freaklabs/NetRad/Hardware/NetRad-v2.0.pdf

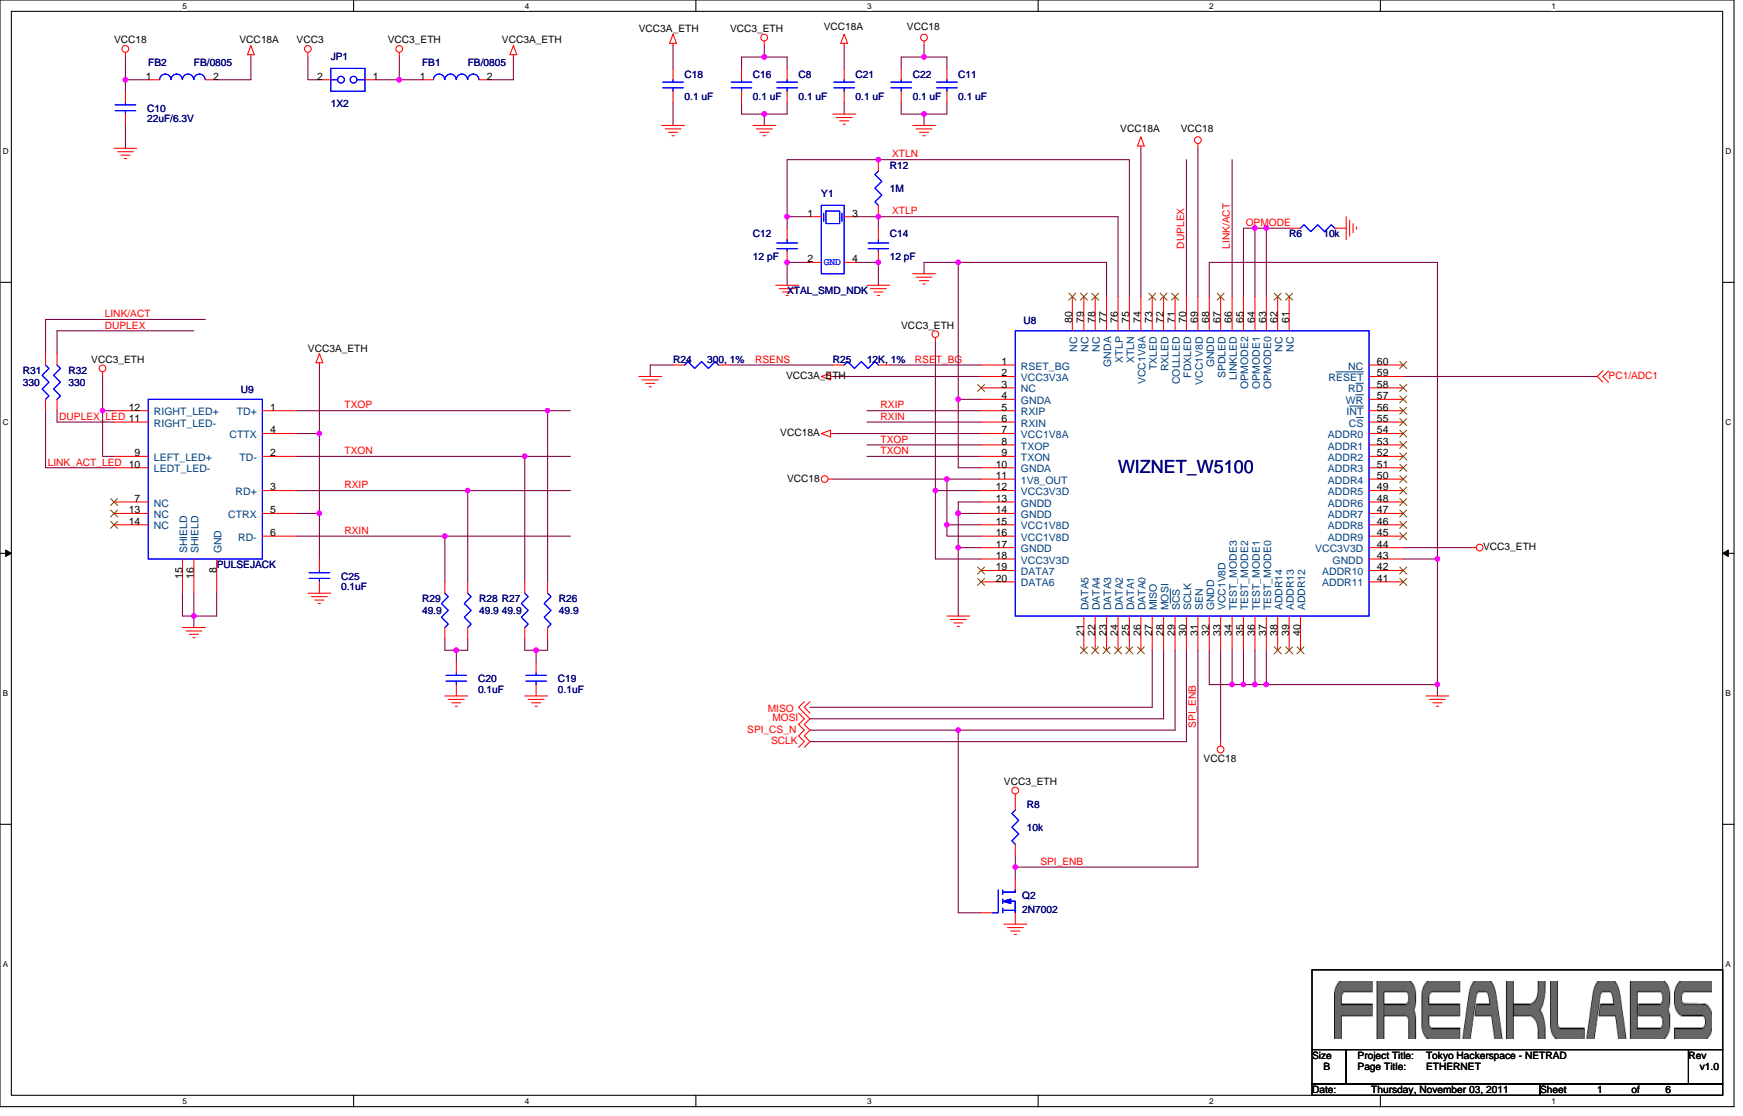
[picture p1: page 1]

NC 61 NC 62 OPMODE0 63 OPMODE1 64 OPMODE2 65 LINKLED 66 SPDLED 67 GNDD 68 VCC1V8D 69 FDXLED 70 COLLLED 71 RXLED 72 TXLED 73 VCC1V8A 74 XTLN 75 XTLP 76 GNDA 77 NC 78 NC 79 NC 80

ADDR12 40 ADDR11 41 ADDR10 42 GNDD 43 VCC3V3D 44 ADDR9 45 ADDR8 46 ADDR7 47 ADDR6 48 ADDR5 49 ADDR4 50 ADDR3 51 ADDR2 52 ADDR1 53 ADDR0 54 CS 55 INT 56 WR 57 RD 58 RESET 59 NC 60

Size Size Size B B B | Project Title: Project Title: Project Title: Tokyo Hackerspace - NETRAD Tokyo Hackerspace - NETRAD Tokyo Hackerspace - NETRAD Page Title: Page Title: Page Title: ETHERNET ETHERNET ETHERNET | Rev Rev Rev v1.0 v1.0 v1.0

Date: Date: Date: Thursday, November 03, 2011 Thursday, November 03, 2011 Thursday, November 03, 2011 | Sheet Sheet Sheet 1 1 1 of of of 6 6 6

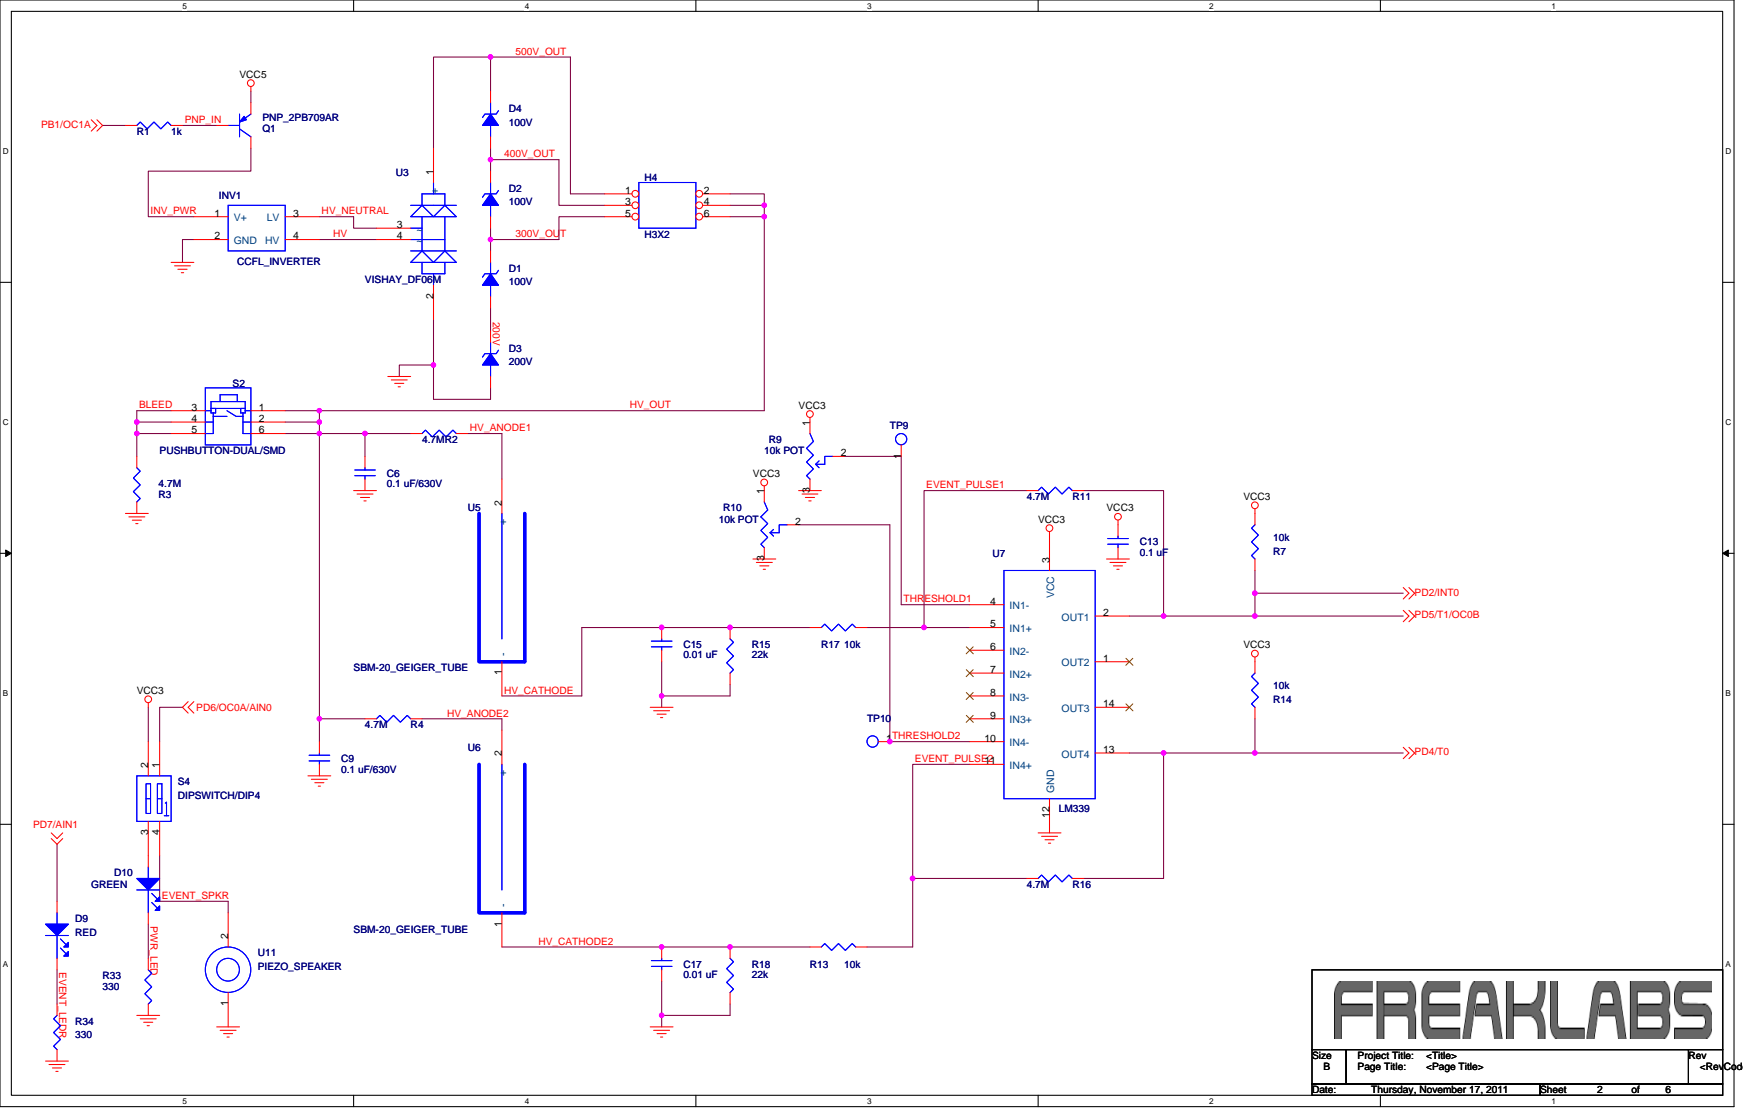
[picture p2: page 2]

Size Size Size B B B | Project Title: Project Title: Project Title: <Title> <Title> <Title> <Page Title> <Page Title> <Page Title> | Rev Rev Rev

Date: Date: Date: Thursday, November 17, 2011 Thursday, November 17, 2011 Thursday, November 17, 2011 | Sheet Sheet Sheet 2 2 2 of of of 6 6 6

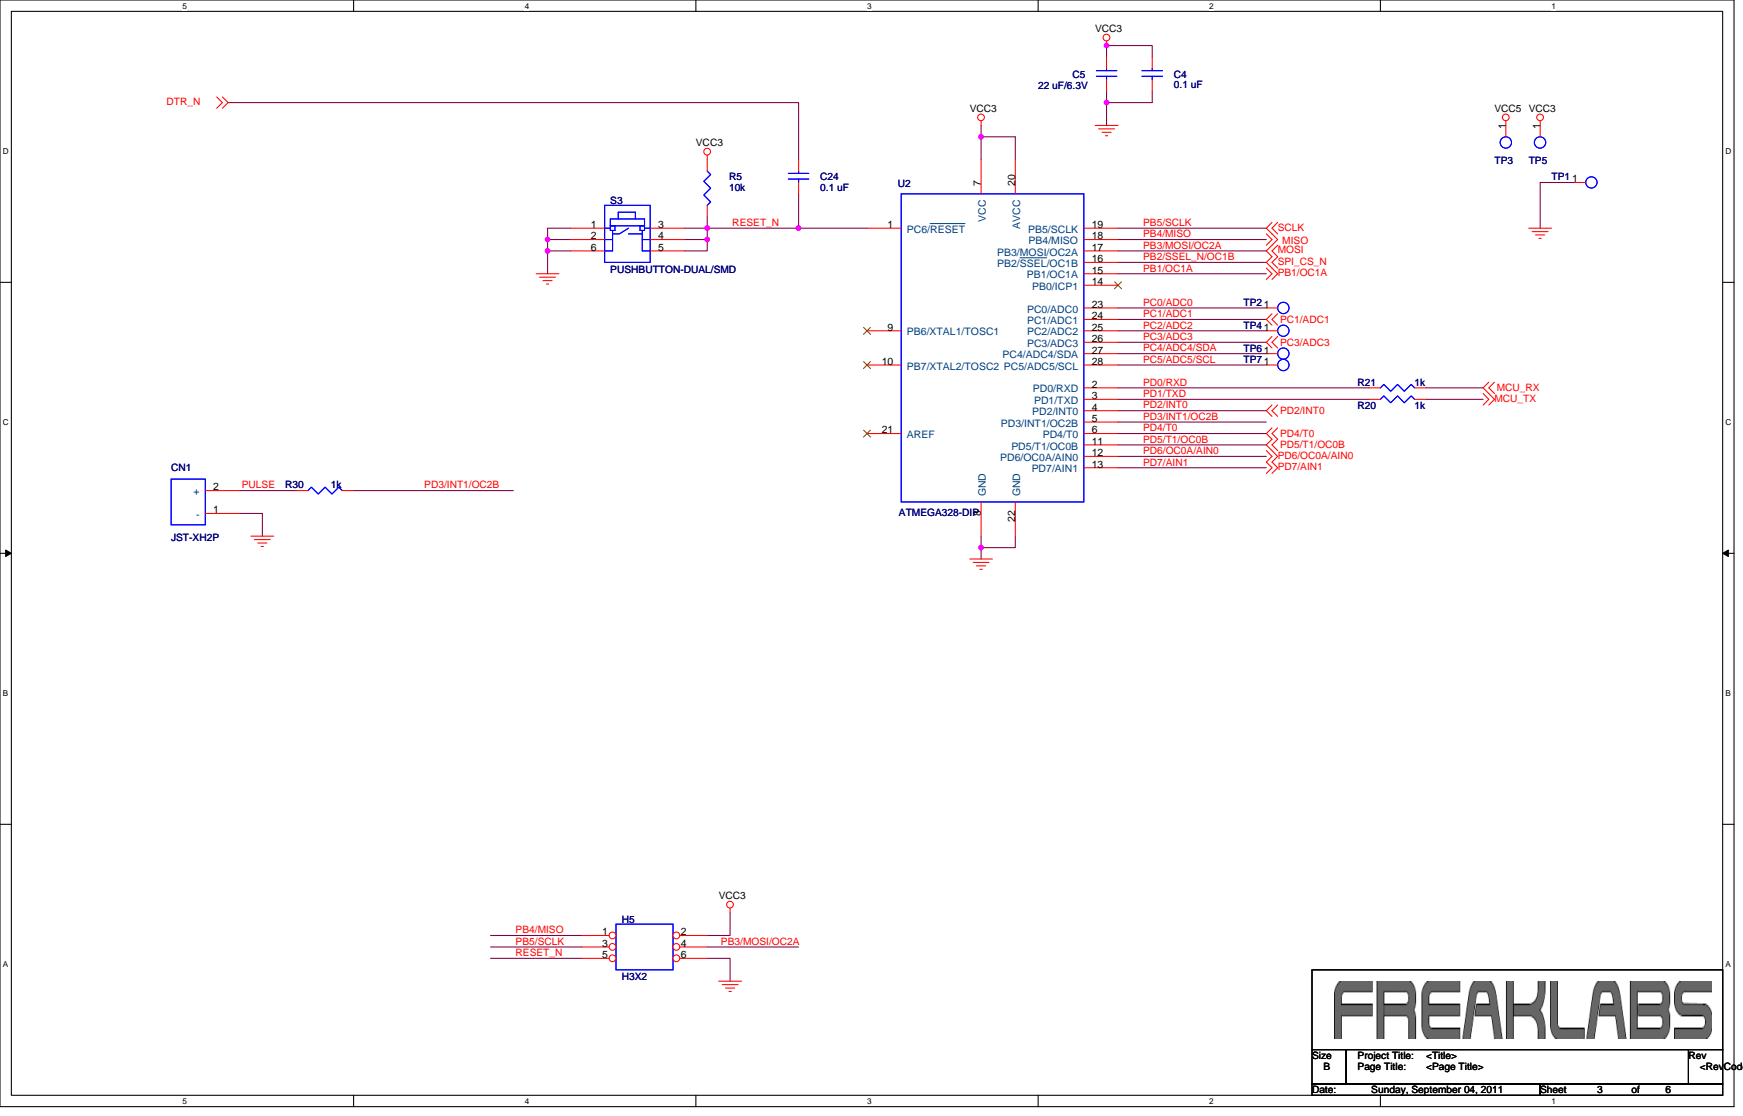
[picture p3: page 3]
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

Date: Date: Date: Sunday, September 04, 2011 Sunday, September 04, 2011 Sunday, September 04, 2011 | Sheet Sheet Sheet 3 3 3 of of of 6 6 6

D | D

H2

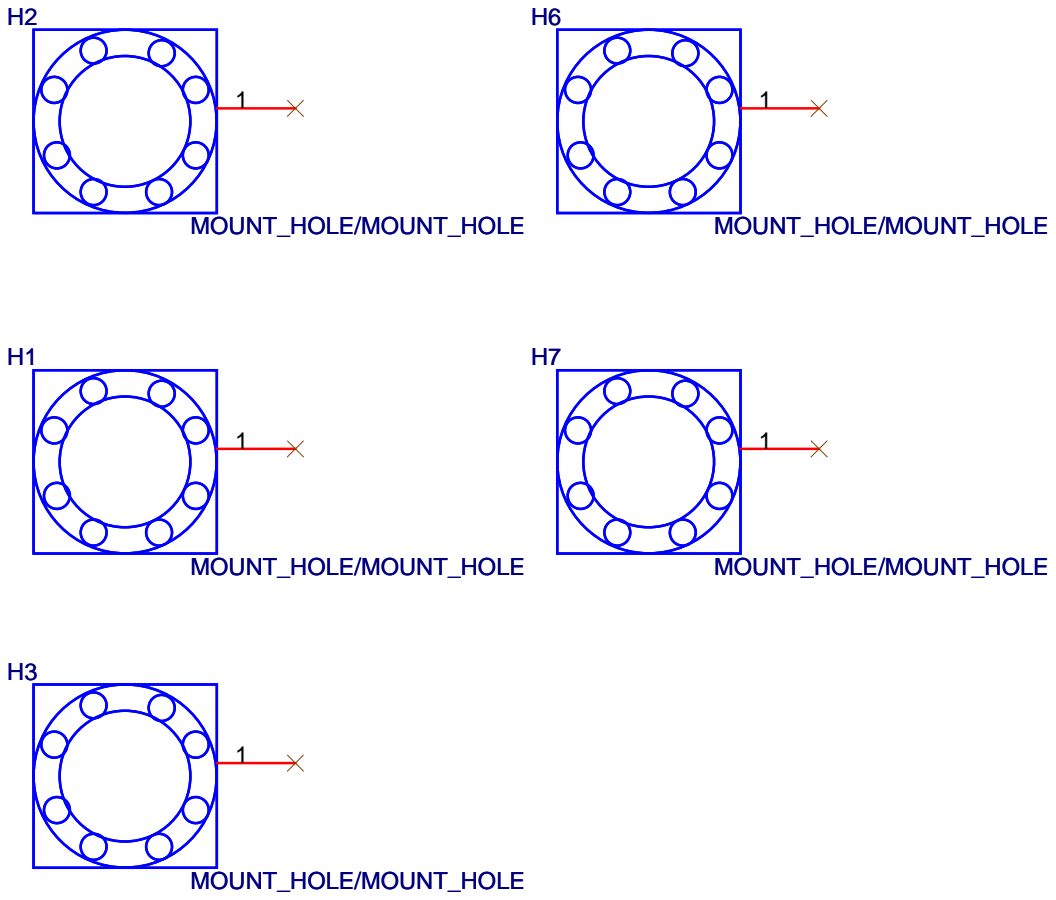
[picture p4: page 4]
Page Title:; <RevCod; MOUNT_HOLE/MOUNT_HOLE

Size Size Size A A A | Project Title: Project Title: Project Title: <Title> <Title> <Title> <Page Title> <Page Title> <Page Title> | Rev Rev Rev

Date: Date: Date: Sunday, September 04, 2011 Sunday, September 04, 2011 Sunday, September 04, 2011 | Sheet Sheet Sheet 4 4 4 of of of 6 6 6

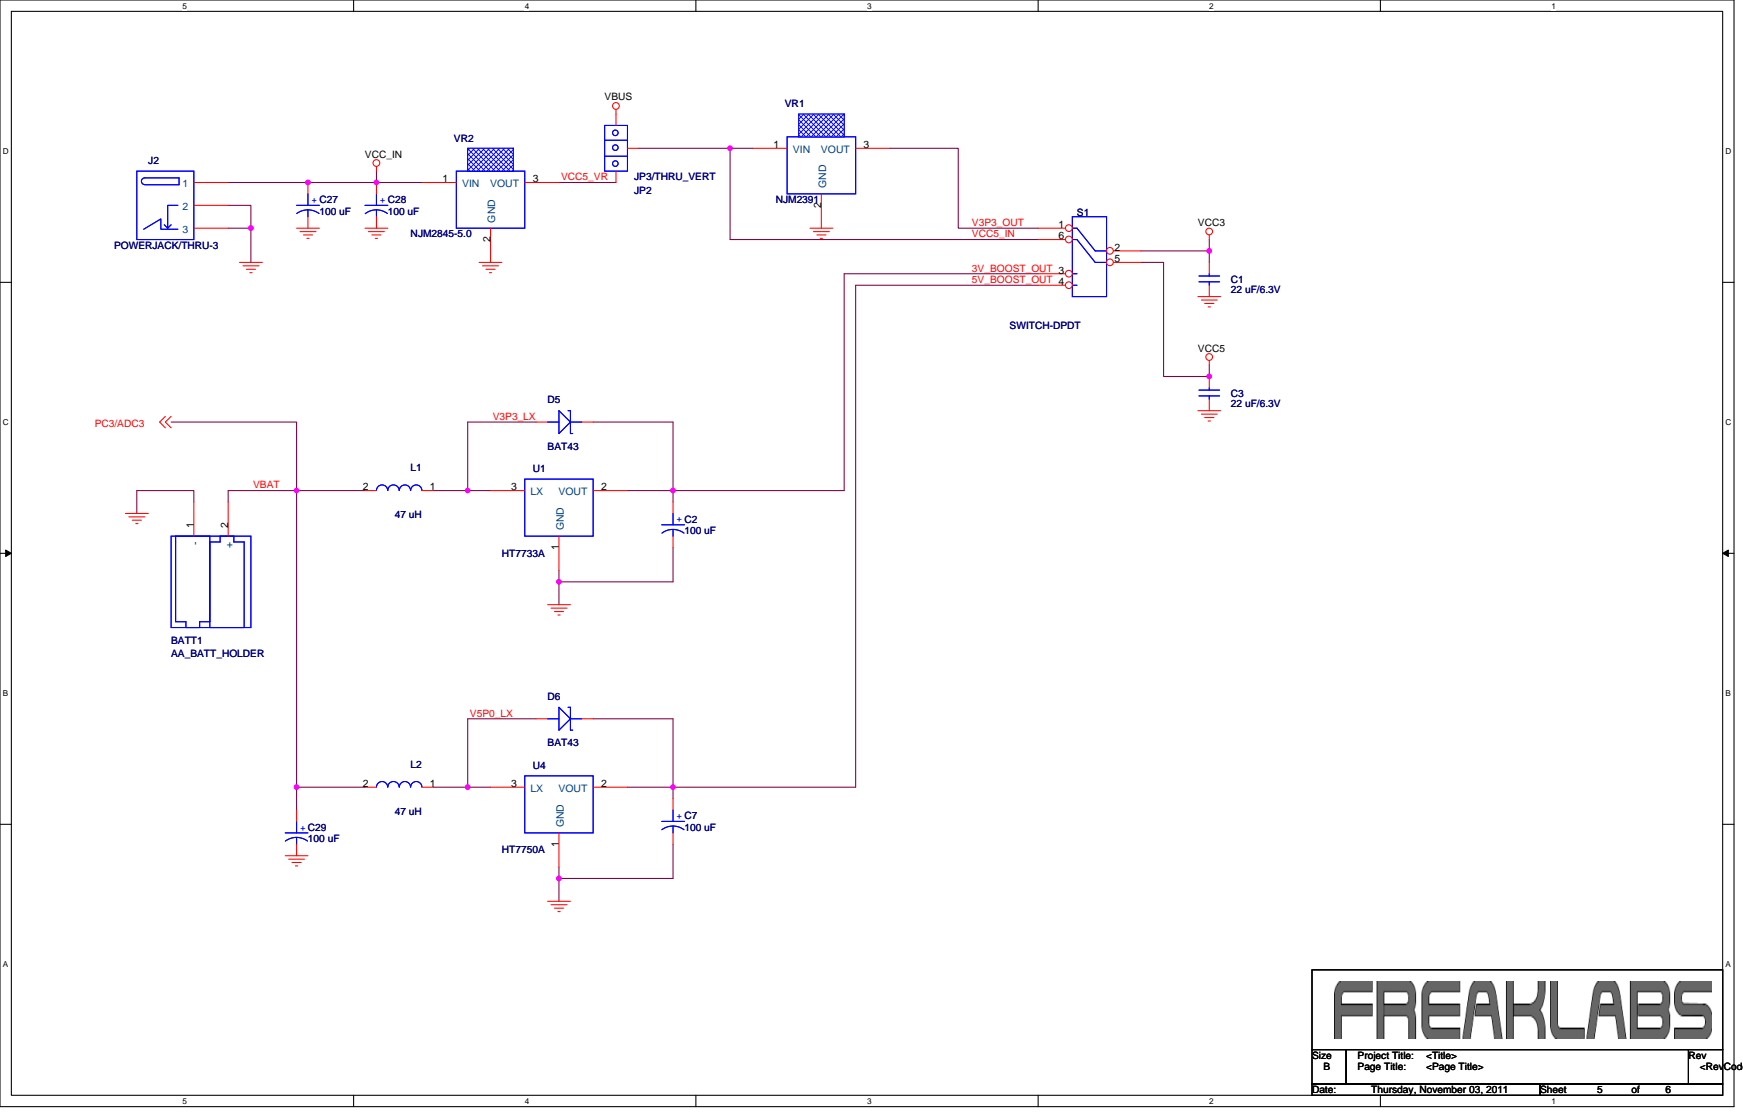
[picture p5: page 5]
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

Date: Date: Date: Thursday, November 03, 2011 Thursday, November 03, 2011 Thursday, November 03, 2011 | Sheet Sheet Sheet 5 5 5 of of of 6 6 6

D | D

## 3V3_USB

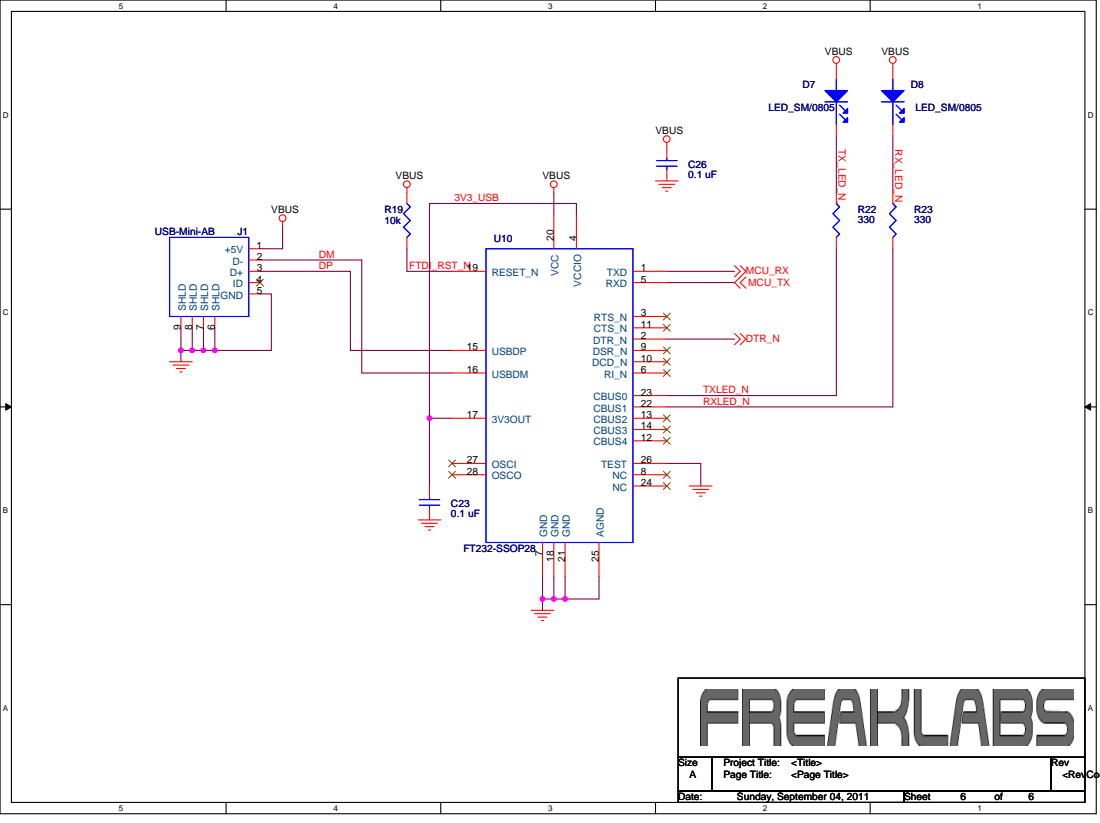
[picture p6: page 6]
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

Date: Date: Date: Sunday, September 04, 2011 Sunday, September 04, 2011 Sunday, September 04, 2011 | Sheet Sheet Sheet 6 6 6 of of of 6 6 6
