freaklabs/NetRad/Hardware/NetRad-v1.0.pdf

D | D

# ETHERNET

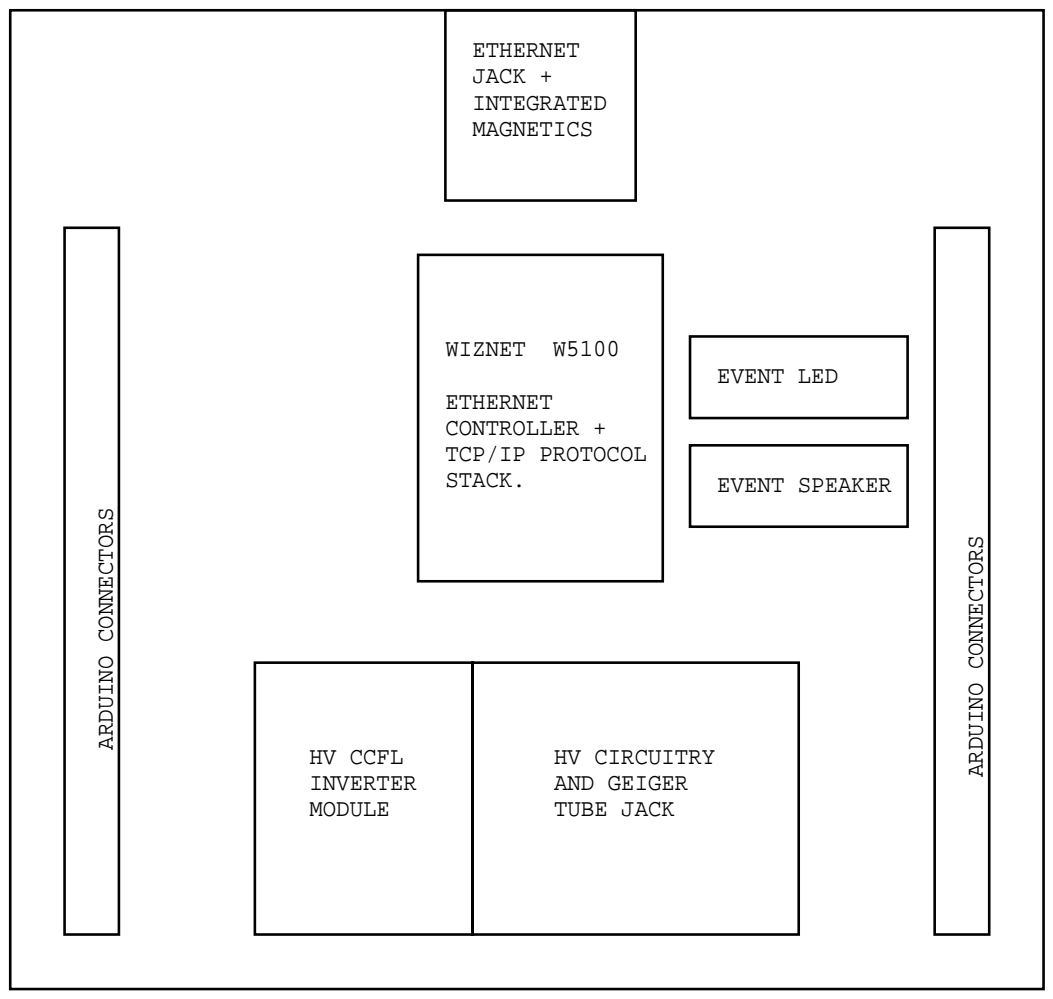
[picture p7: page 1]
HV CIRCUITRY AND GEIGER TUBE JACK; HV CCFL INVERTER MODULE; WIZNET W5100; ETHERNET CONTROLLER + TCP/IP PROTOCOL STACK.; JACK + INTEGRATED MAGNETICS; ARDUINO CONNECTORS; EVENT LED; EVENT SPEAKER

Size Size Size A A A | Project Title: Project Title: Project Title: Tokyo Hackerspace - NETRAD Tokyo Hackerspace - NETRAD Tokyo Hackerspace - NETRAD Page Title: Page Title: Page Title: BLOCK_DIAGRAM BLOCK_DIAGRAM BLOCK_DIAGRAM | Rev Rev Rev v 1.0 v 1.0 v 1.0

Date: Date: Date: Thursday, April 21, 2011 Thursday, April 21, 2011 Thursday, April 21, 2011 | Sheet Sheet Sheet 1 1 1 of of of 3 3 3

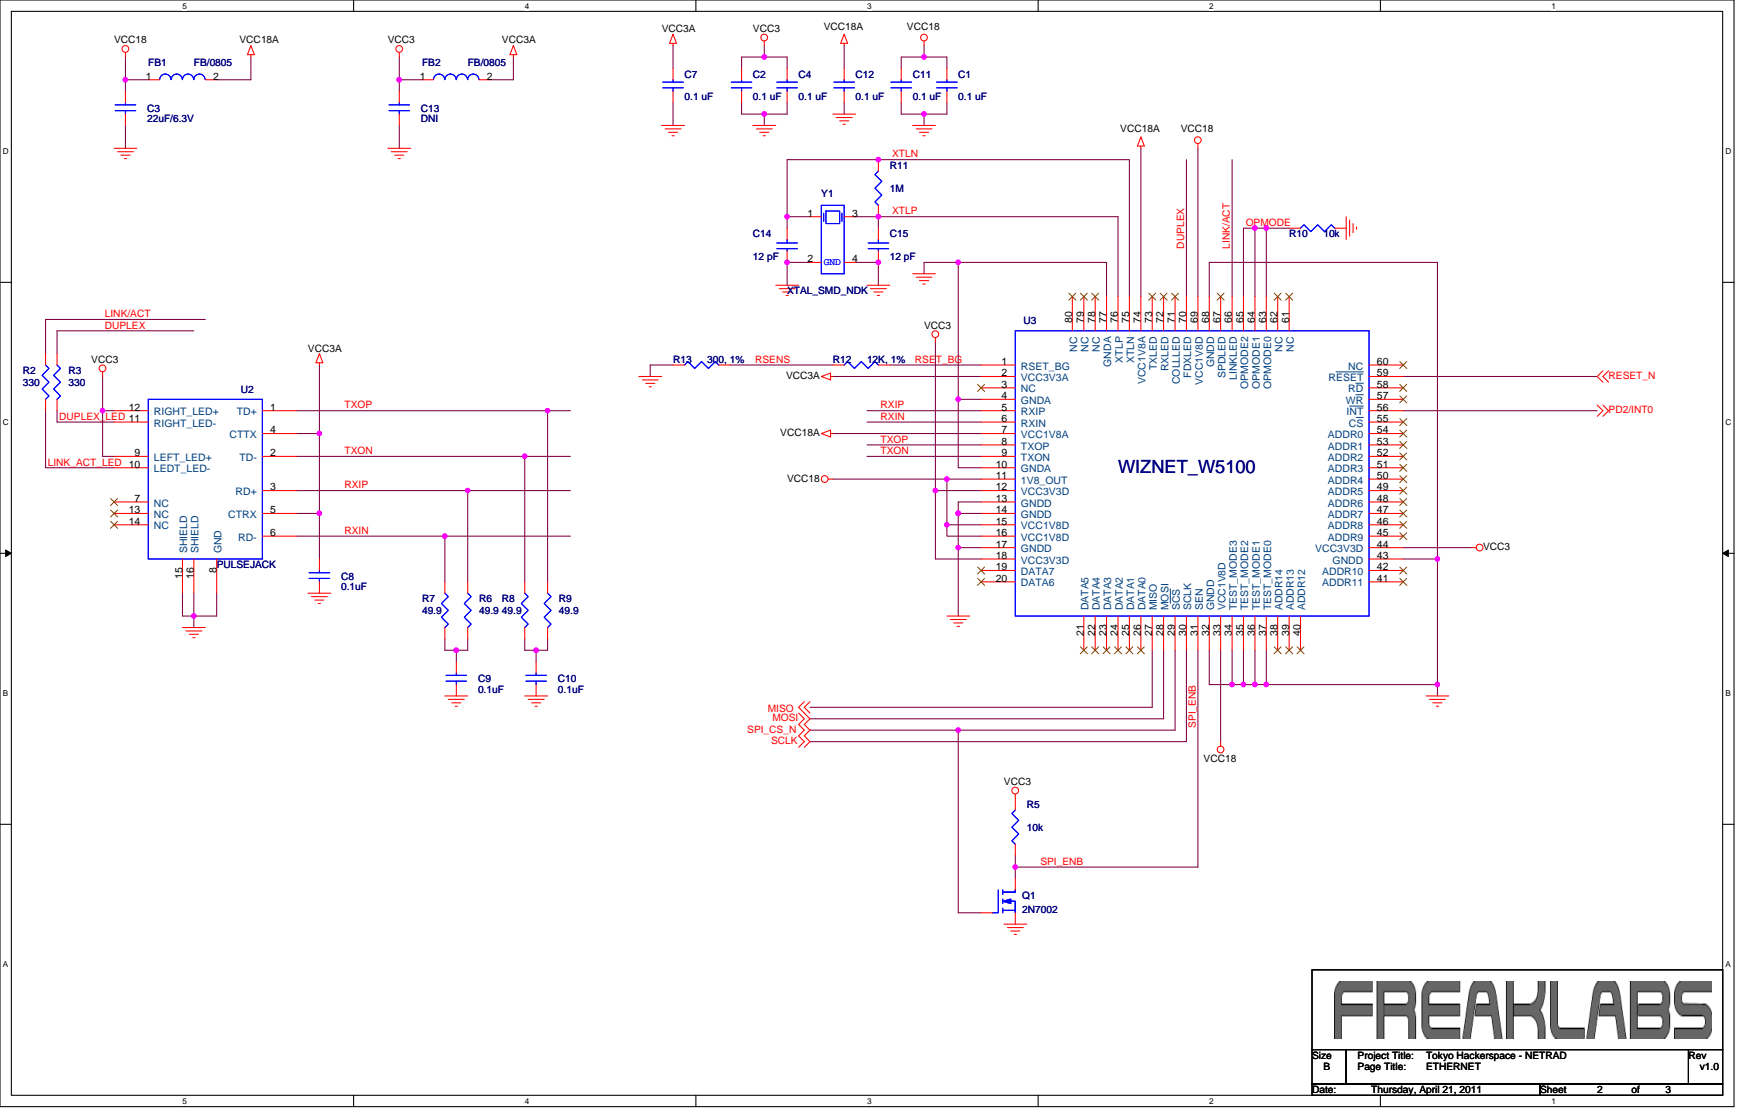
[picture p8: page 2]

NC 61 NC 62 OPMODE0 63 OPMODE1 64 OPMODE2 65 LINKLED 66 SPDLED 67 GNDD 68 VCC1V8D 69 FDXLED 70 COLLLED 71 RXLED 72 TXLED 73 VCC1V8A 74 XTLN 75 XTLP 76 GNDA 77 NC 78 NC 79 NC 80

ADDR12 40 ADDR11 41 ADDR10 42 GNDD 43 VCC3V3D 44 ADDR9 45 ADDR8 46 ADDR7 47 ADDR6 48 ADDR5 49 ADDR4 50 ADDR3 51 ADDR2 52 ADDR1 53 ADDR0 54 CS 55 INT 56 WR 57 RD 58 RESET 59 NC 60

Size Size Size B B B | Project Title: Project Title: Project Title: Tokyo Hackerspace - NETRAD Tokyo Hackerspace - NETRAD Tokyo Hackerspace - NETRAD Page Title: Page Title: Page Title: ETHERNET ETHERNET ETHERNET | Rev Rev Rev v1.0 v1.0 v1.0

Date: Date: Date: Thursday, April 21, 2011 Thursday, April 21, 2011 Thursday, April 21, 2011 | Sheet Sheet Sheet 2 2 2 of of of 3 3 3

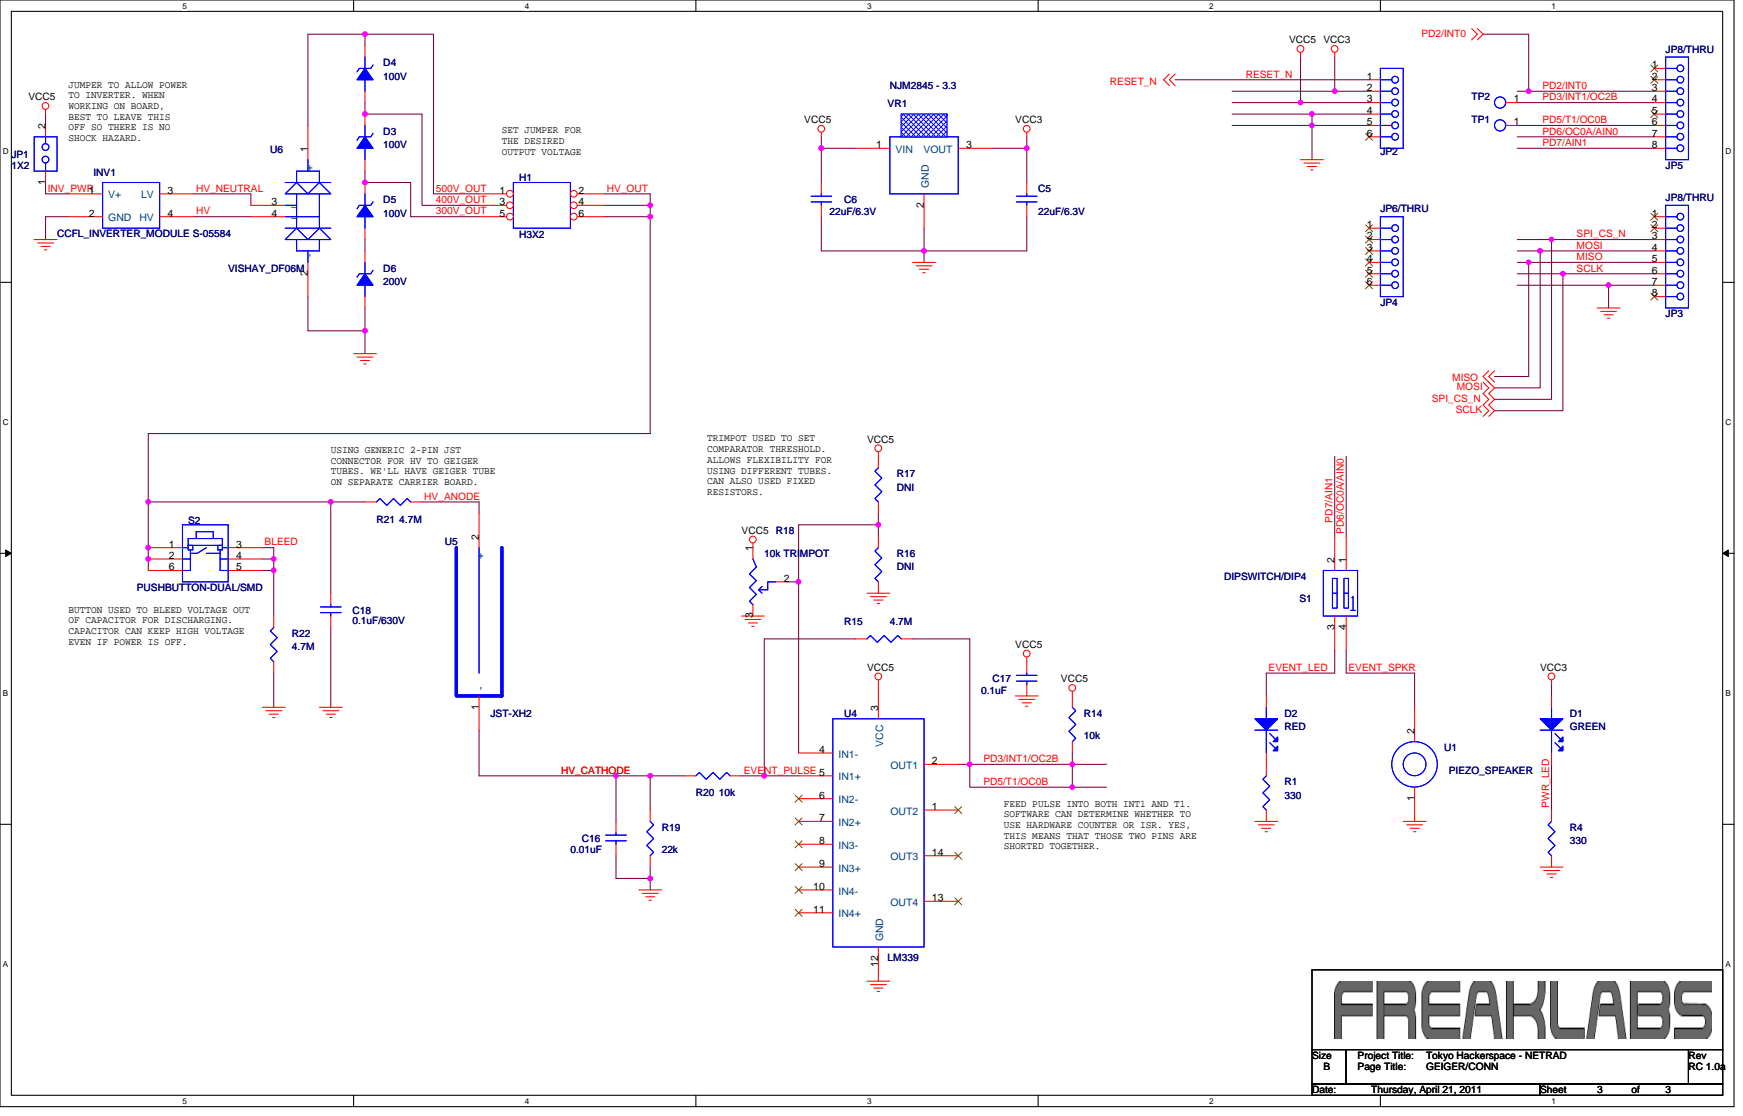
[picture p9: page 3]

JUMPER TO ALLOW POWER
TO INVERTER. WHEN
WORKING ON BOARD,
BEST TO LEAVE THIS
OFF SO THERE IS NO
SHOCK HAZARD.

USING GENERIC 2-PIN JST
CONNECTOR FOR HV TO GEIGER
TUBES. WE'LL HAVE GEIGER TUBE
ON SEPARATE CARRIER BOARD.

TRIMPOT USED TO SET
COMPARATOR THRESHOLD.
ALLOWS FLEXIBILITY FOR
USING DIFFERENT TUBES.
CAN ALSO USED FIXED
RESISTORS.

BUTTON USED TO BLEED VOLTAGE OUT
OF CAPACITOR FOR DISCHARGING.
CAPACITOR CAN KEEP HIGH VOLTAGE
EVEN IF POWER IS OFF.

FEED PULSE INTO BOTH INT1 AND T1.
SOFTWARE CAN DETERMINE WHETHER TO
USE HARDWARE COUNTER OR ISR. YES,
THIS MEANS THAT THOSE TWO PINS ARE
SHORTED TOGETHER.

Size Size Size B B B | Project Title: Project Title: Project Title: Tokyo Hackerspace - NETRAD Tokyo Hackerspace - NETRAD Tokyo Hackerspace - NETRAD Page Title: Page Title: Page Title: GEIGER/CONN GEIGER/CONN GEIGER/CONN | Rev Rev Rev RC 1.0a RC 1.0a RC 1.0a

Date: Date: Date: Thursday, April 21, 2011 Thursday, April 21, 2011 Thursday, April 21, 2011 | Sheet Sheet Sheet 3 3 3 of of of 3 3 3

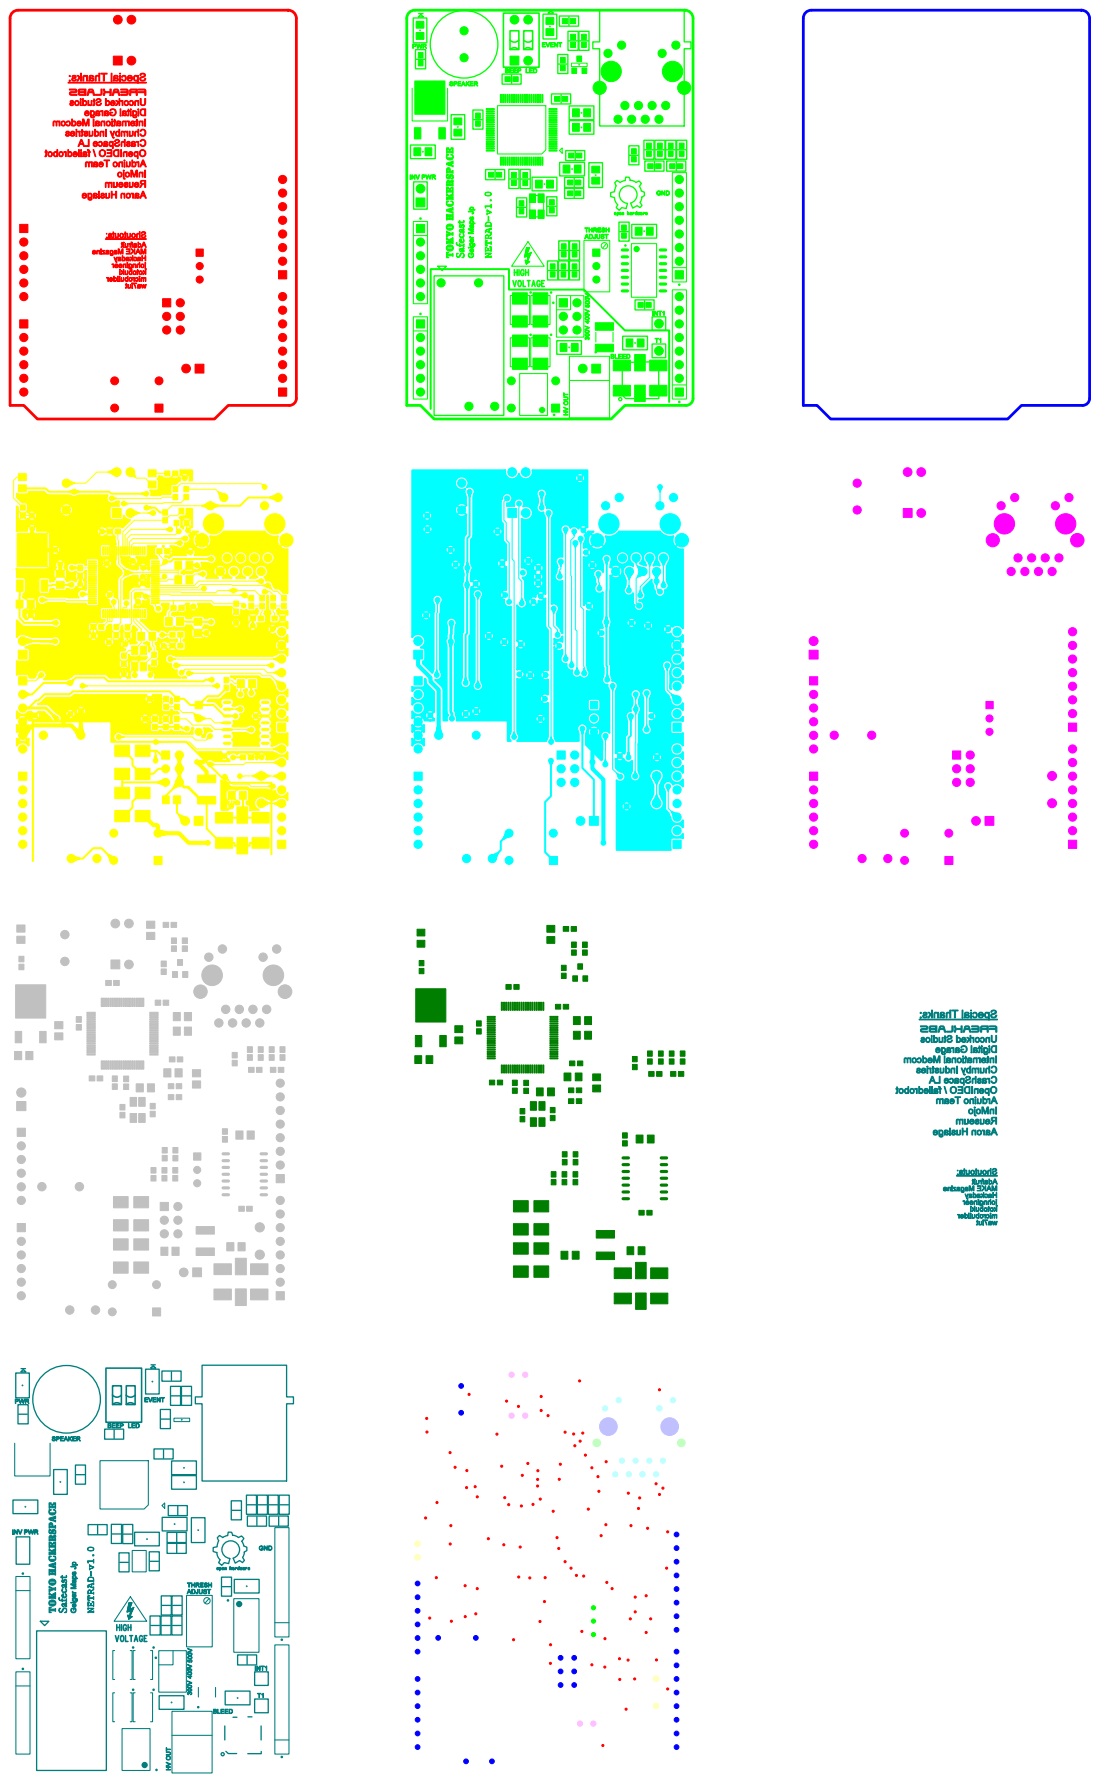
[picture p10: page 4]
