freaklabs/NetRad/(commit log)

2012-09-23 Added
    Added NetRad schematics and software. These were located in various
    places around the internet but I'm trying to centralize the location of
    all my projects.
2012-09-23 Added v2.0 schematic
    NetRad v2.0 hardware incorporates the wiznet, arduino, high voltage
    geiger driver, and counting circuit on to 1 PCB. It makes it much easier
    to put together a standalone stationary geiger monitor.
